CCHS-Melbourne/Swag-Badge/README.md

# Linux Conference Australia 2021: SwagBadge

Hardware design files for the [LCA2021 conference](http://lca2021.linux.org.au)
attendee swag badge and [Open Hardware MiniConference workshop 2021](https://linux.conf.au/programme/miniconfs/open-hardware/).
[SwagBadge schematic diagram](swag-badge-schematic.pdf)

Download and flash the [SwagBadge application firmware and Aiko Engine framework](https://github.com/geekscape/aiko_engine_mp).

See the [Open Hardware MiniConference SwagBadge Wiki](http://www.openhardwareconf.org/wiki/Swagbadge2021) for project details.

Visit the [LCA2021 SwagBadge community forum](https://spectrum.chat/lca2021-swagbadge) for technical support, particular over December 2020 and January 2021,
prior to and during the LCA2021 conference.

A project by the Melbourne [Connected Community HackerSpace](https://www.hackmelbourne.org)

Licensed under MIT (See the [license](LICENSE) file)
