CCHS-Melbourne/Swag-Badge/3D Models/LOLIN32 Lite.step

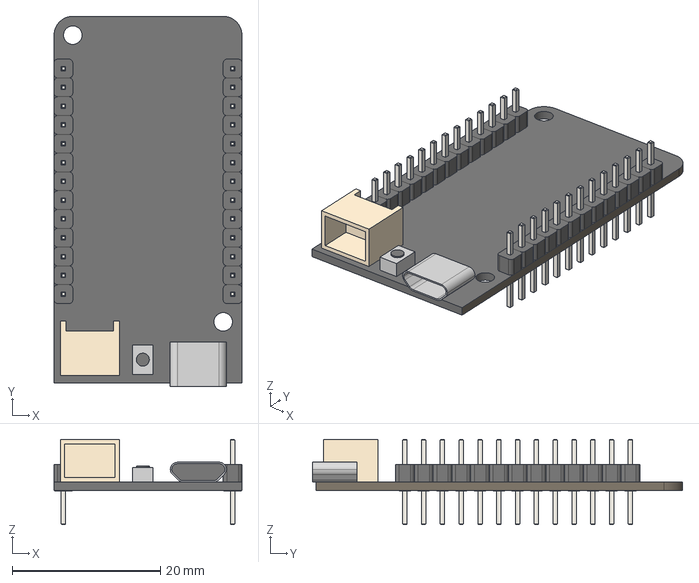
[picture p1: CAD file, 2020-10-05]
3D Models/LOLIN32 Lite.step
25.4 x 50.0 x 11.6 mm
