CCHS-Melbourne/Swag-Badge/DXF/Master Layout Grid.dxf

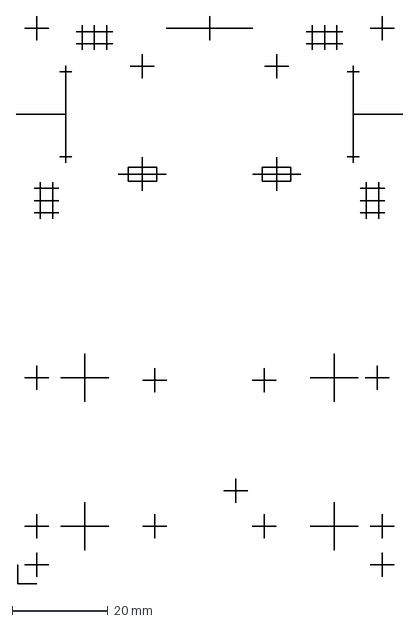
[picture p2: CAD file, 2020-10-08]
DXF/Master Layout Grid.dxf
80.6 x 118.5 mm
