CCHS-Melbourne/Swag-Badge/3D Models/0.96 OLED v3.step

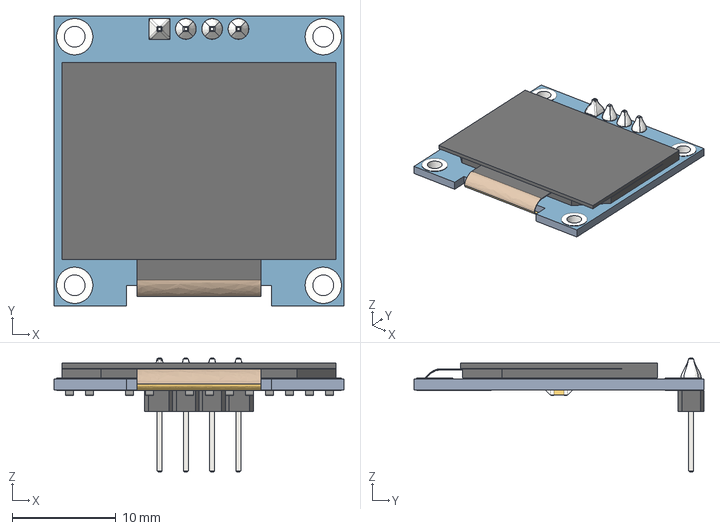
[picture p3: CAD file, 2020-10-05]
3D Models/0.96 OLED v3.step
28.0 x 28.0 x 11.0 mm
