CCHS-Melbourne/Swag-Badge/DXF/Slider 4Finger Pads.dxf

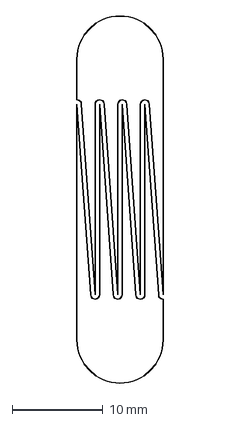
[picture p4: CAD file, 2020-10-06]
DXF/Slider 4Finger Pads.dxf
9.50 x 40.5 mm
