CCHS-Melbourne/Swag-Badge/3D Models/6x3mm Button.stp

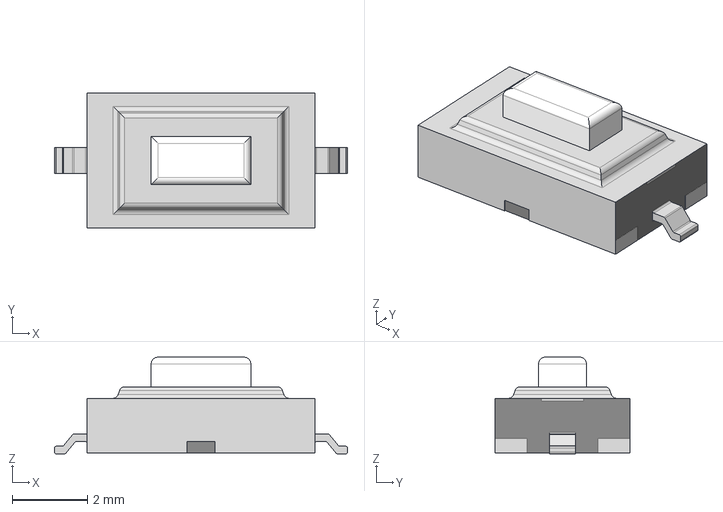
[picture p5: CAD file, 2020-10-05]
3D Models/6x3mm Button.stp
7.77 x 3.58 x 2.57 mm
