CCHS-Melbourne/Swag-Badge/DXF/Slider Silk.dxf

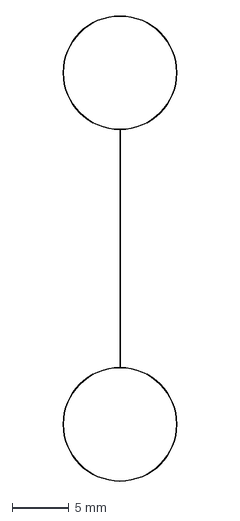
[picture p6: CAD file, 2020-10-06]
DXF/Slider Silk.dxf
10.0 x 41.0 mm
