CCHS-Melbourne/Swag-Badge/3D Models/Tactile_SMD_3x6x2.5mm.STEP

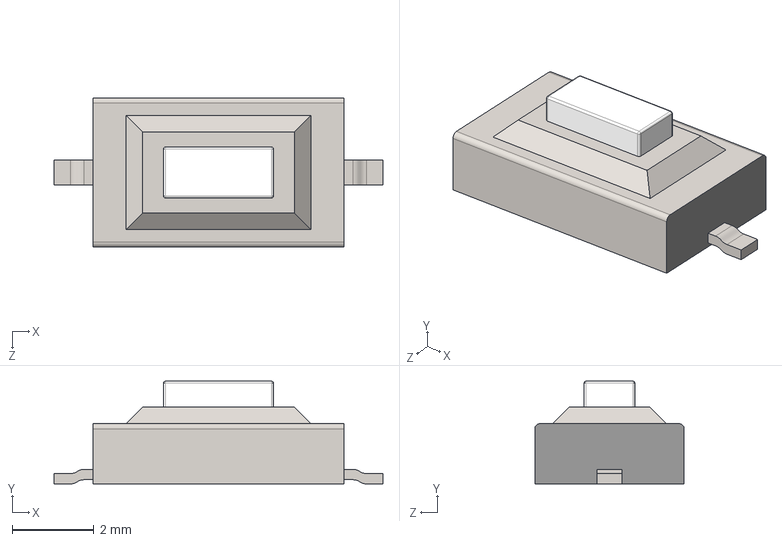
[picture p7: CAD file, 2020-10-05]
3D Models/Tactile_SMD_3x6x2.5mm.STEP
8.05 x 2.51 x 3.66 mm
