CCHS-Melbourne/Swag-Badge/DXF/EdgeCuts01.dxf

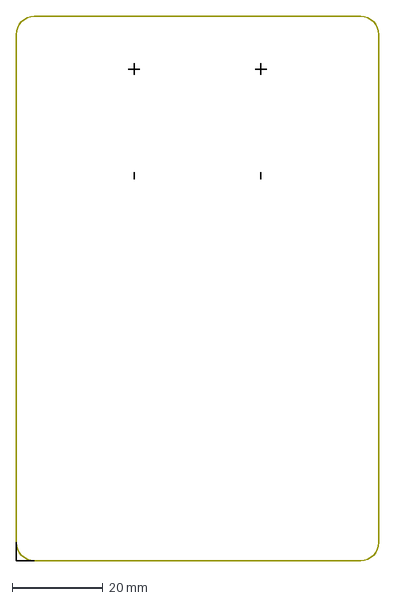
[picture p8: CAD file, 2020-10-05]
DXF/EdgeCuts01.dxf
80.0 x 120.0 mm
