CCHS-Melbourne/Swag-Badge/swag-badge-schematic.pdf

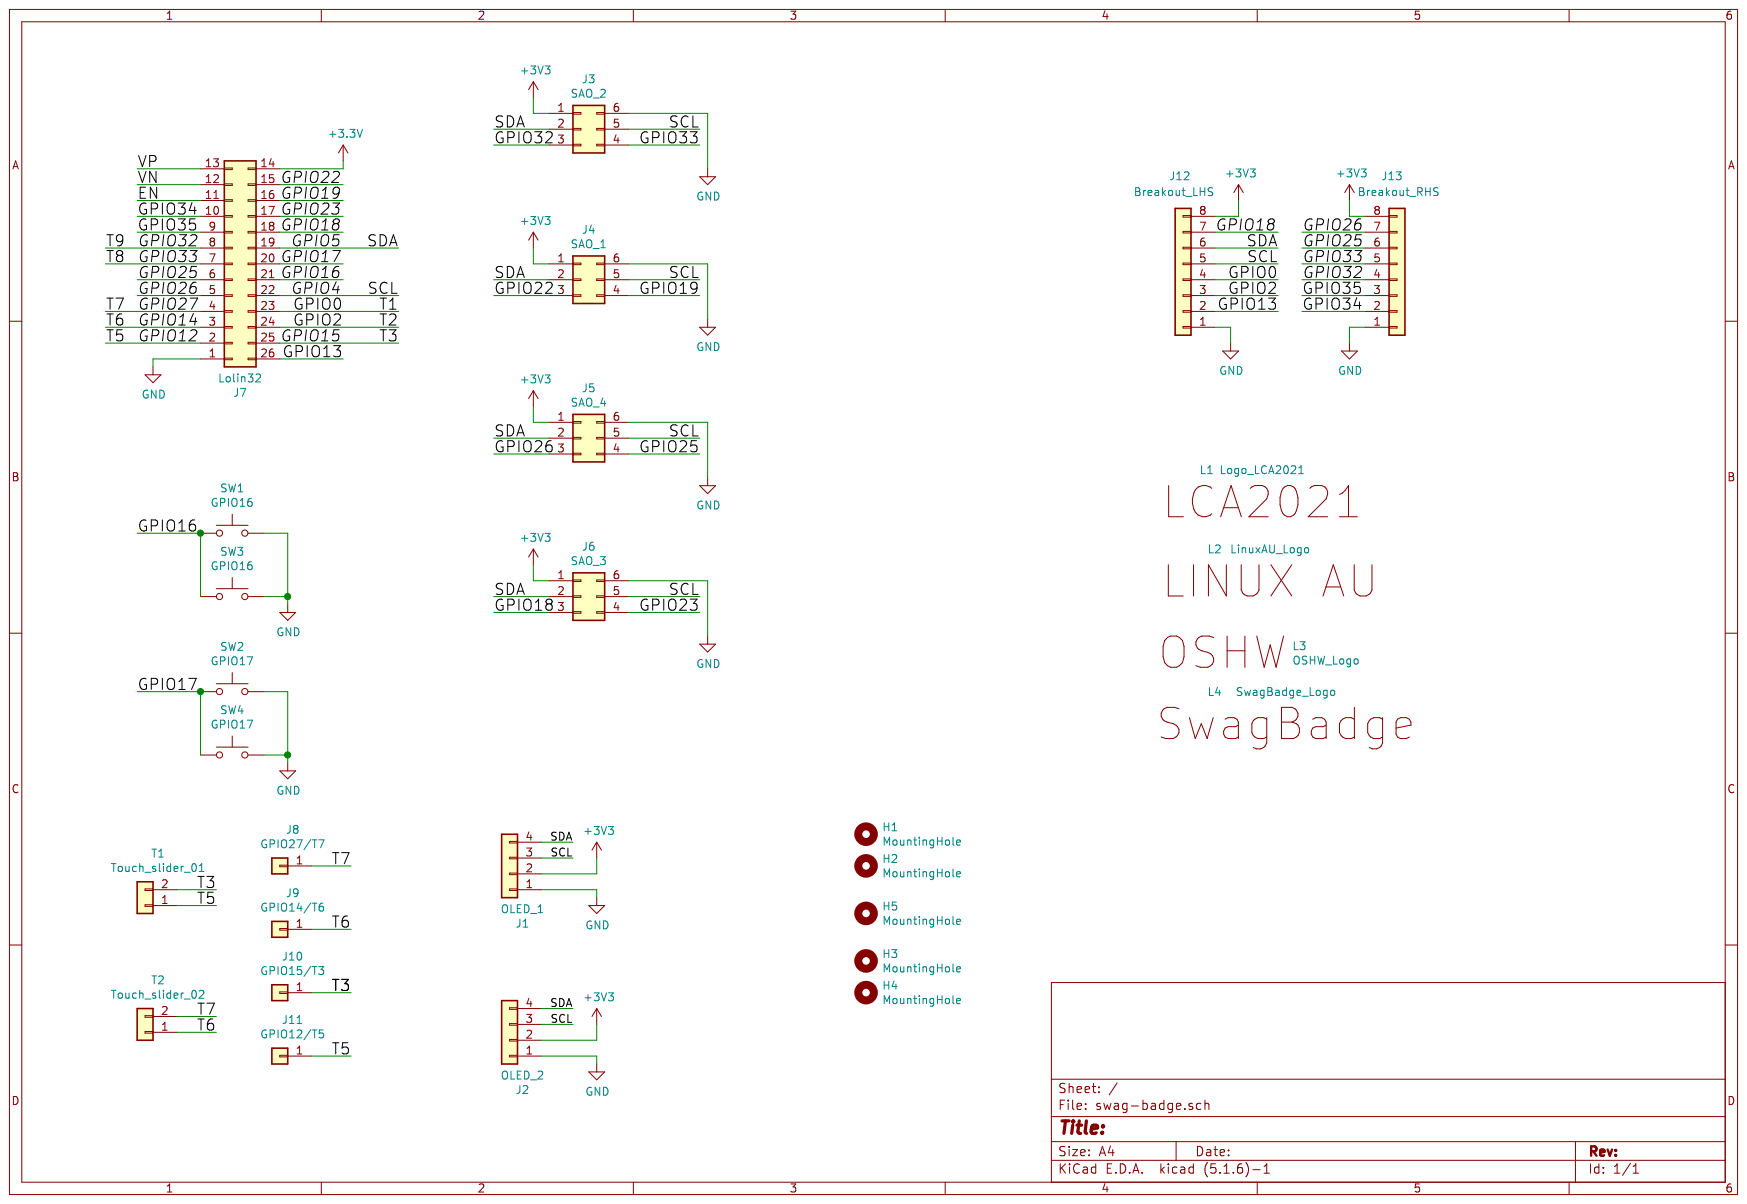
[picture p9: page 1]
