CCHS-Melbourne/Swag-Badge/(commit log)

2020-10-01 Removed tinypico footprint :(
    [swag-badge.sch]
2020-10-04 Footprints Added
2020-10-04 Footprints associated
    [swag-badge.kicad_pcb, swag-badge.sch]
2020-10-05 Tactile buttons added
    [0.96 OLED v3.step, 6x3mm Button.stp, EdgeCuts01.dxf, Tactile_SMD_3x6x2.5mm.STEP, swag-badge.kicad_pcb, swag-badge.sch]
2020-10-05 Footprint renamed and reassociated
    [swag-badge.kicad_pcb, swag-badge.sch]
2020-10-05 LOLIN32 3D Model Added
    [LOLIN32 Lite (Old).step, LOLIN32 Lite.step, swag-badge.kicad_pcb]
2020-10-05 Minor revisions
    [LOLIN32 Lite (Old).step, swag-badge.kicad_pcb]
2020-10-05 Added buttons and sliders.
    [swag-badge.sch]
2020-10-05 Sense sliders added to PCB
    [swag-badge.kicad_pcb, swag-badge.sch]
2020-10-05 switched to internal pullups for buttons
    [swag-badge.sch]
2020-10-06 New Touch Slider
    [Slider 4Finger Pads.dxf, Slider Silk.dxf, swag-badge.kicad_pcb, swag-badge.sch]
2020-10-06 Minor updates to slider silks
    [swag-badge.kicad_pcb]
2020-10-06 4th SAO added
    [swag-badge.kicad_pcb, swag-badge.sch]
2020-10-07 Just SAO things.
    [swag-badge.sch]
2020-10-07 Pad extensions added
    [swag-badge.kicad_pcb, swag-badge.sch]
2020-10-07 Lanyard holes for everyone
    [swag-badge.kicad_pcb, swag-badge.sch]
2020-10-07 Breakouts added
    [swag-badge.kicad_pcb, swag-badge.sch]
2020-10-07 Many small footprint updates
    Many small updates, most importantly, SAO layout now appears to be to spec.
    [swag-badge.kicad_pcb, swag-badge.sch]
2020-10-07 LCA Logo added
    [swag-badge.kicad_pcb, swag-badge.sch]
2020-10-08 Added GPIO pins to SAO4
    [swag-badge.sch]
2020-10-08 Reduced breakout added to schematic
    [swag-badge.sch]
2020-10-08 Updated 8 pin breakouts.
    [swag-badge.sch]
2020-10-08 Minor footprint work
    [swag-badge.kicad_pcb, swag-badge.sch]
2020-10-08 Updated Component names to reflect purpose.
    [swag-badge.sch]
2020-10-08 Footprint updates
    [swag-badge.kicad_pcb]
2020-10-08 Welcome to the grid
    [swag-badge.kicad_pcb, swag-badge.sch]
2020-10-08 Minor adjustments
    [swag-badge.kicad_pcb]
2020-10-08 Second LED hole added
    [swag-badge.kicad_pcb]
2020-10-08 Breakout pins labelled
    [swag-badge.kicad_pcb]
2020-10-08 Routing started
    Feel free to delete and start again. Just noodling.
    [Master Layout Grid.dxf, swag-badge.kicad_pcb, swag-badge.sch]
2020-10-08 Keepouts around mount holes modified
    [swag-badge.kicad_pcb]
2020-10-08 Switch position moved to 16mm
    [swag-badge.kicad_pcb]
2020-10-08 Starting to Route
    [swag-badge.kicad_pcb, swag-badge.sch]
2020-10-08 More routing.
    [swag-badge.kicad_pcb, swag-badge.sch]
2020-10-08 Yet more routing
    [swag-badge.kicad_pcb]
2020-10-08 Adding extra switches for dual footprint.
    [swag-badge.sch]
2020-10-08 Routing first pass complete.
    [swag-badge.kicad_pcb, swag-badge.sch]
2020-10-08 OSHW logo added
    [swag-badge.kicad_pcb, swag-badge.sch]
2020-10-08 Labelling updated
    [swag-badge.kicad_pcb]
2020-10-09 LinuxAU Logo added
    [swag-badge.kicad_pcb, swag-badge.sch]
2020-10-09 Logo placement
    [swag-badge.kicad_pcb]
2020-10-09 Minor tweaks
    [swag-badge.kicad_pcb]
2020-10-09 SAO 3 rotated 180
    Some additional neatening
    [swag-badge.kicad_pcb]
2020-10-09 Minor trace edit
    [swag-badge.kicad_pcb]
2020-10-10 SwagBadge Logo added
    [swag-badge.kicad_pcb, swag-badge.sch]
2020-10-10 Credits added
    [swag-badge.kicad_pcb]
2020-10-10 Trace neatening
    [swag-badge.kicad_pcb]
2020-10-11 Minor cleanup
    [swag-badge.kicad_pcb]
2020-10-11 Minor updates
    [swag-badge.kicad_pcb]
2020-10-11 Minor silks edit
    [swag-badge.kicad_pcb]
2020-10-11 SAOs rotated 45° Silks updated
    Credits still need to be verified
    [swag-badge(Backup).kicad_pcb]
2020-10-11 Minor silk edit waiting on credits
    [swag-badge.kicad_pcb]
2020-10-11 DRC fixes
    [swag-badge.kicad_pcb, swag-badge.sch]
2020-10-11 Minor silk updates
    [swag-badge.kicad_pcb]
2020-10-11 Gerbers added
    [swag-badge-B_Cu.gbr, swag-badge-B_Mask.gbr, swag-badge-B_SilkS.gbr, swag-badge-Edge_Cuts.gbr, swag-badge-F_Cu.gbr, swag-badge-F_Mask.gbr, swag-badge-F_SilkS.gbr, swag-badge-job.gbrjob]
2020-10-11 NPTH and PTH drill files separated
    [swag-badge-B_Cu.gbr, swag-badge-B_Mask.gbr, swag-badge-B_SilkS.gbr, swag-badge-Edge_Cuts.gbr, swag-badge-F_Cu.gbr, swag-badge-F_Mask.gbr, swag-badge-F_SilkS.gbr, swag-badge-NPTH.drl]
2020-10-11 Removed first version of Gerbers
2020-10-12 New Gerbers from Aux Origin
    New gerbers generated after fab error. Failed gerbers saved in .zip - Do not use
    [swag-badge-B_Cu.gbr, swag-badge-B_Mask.gbr, swag-badge-B_SilkS.gbr, swag-badge-Edge_Cuts.gbr, swag-badge-F_Cu.gbr, swag-badge-F_Mask.gbr, swag-badge-F_SilkS.gbr, swag-badge-NPTH.drl]
2020-10-12 SAO_3 Silk Edited - New Gerbers
    [swag-badge-B_Cu.gbr, swag-badge-B_Mask.gbr, swag-badge-B_SilkS.gbr, swag-badge-Edge_Cuts.gbr, swag-badge-F_Cu.gbr, swag-badge-F_Mask.gbr, swag-badge-F_SilkS.gbr, swag-badge-NPTH.drl]
2020-10-25 3v3 and GND backwards
    insert giant groaning noise
    [swag-badge.kicad_pcb, swag-badge.sch]
2020-10-26 SAO pins highlighted on Back Silk
    [swag-badge.kicad_pcb]
2020-10-27 Updated Silks, new Gerbers
    [swag-badge-B_Cu.gbr, swag-badge-B_Mask.gbr, swag-badge-B_SilkS.gbr, swag-badge-Edge_Cuts.gbr, swag-badge-F_Cu.gbr, swag-badge-F_Mask.gbr, swag-badge-F_SilkS.gbr, swag-badge-NPTH.drl]
2020-10-27 Silk update not included in last commit
    [swag-badge.kicad_pcb]
2020-10-27 Minor update
    [swag-badge-B_Cu.gbr, swag-badge-B_Mask.gbr, swag-badge-B_SilkS.gbr, swag-badge-Edge_Cuts.gbr, swag-badge-F_Cu.gbr, swag-badge-F_Mask.gbr, swag-badge-F_SilkS.gbr, swag-badge-NPTH.drl]
2020-12-22 Provide more ddocumentation, e.g schematic diagram and links to technical support and SwagBadge application firmware (Aiko Engine).
